jackyzha0/DroneNet/WRITEUP_ARXIV_FORM.pdf

## DRONENET: USING DRONE SWARMS FOR AUTONOMOUS

## SEARCH AND RESCUE

AN INDEPENDENT PROJECT

Jacky Zhao St. George’s School Vancouver, CA
j.zhao2k19@gmail.com

March 1, 2019

ABSTRACT

Current search and rescue methods are very reliant on global communication
methods like GPS or a central control unit. | This limits the range and
efficiency of search and rescue operations. | A decentralized drone swarm
would alleviate these problems by having a theoretically infinite range given number of drones. So far, we have designed and assembled the first drone using 3D printed components and ordered parts, built the recognition network by retraining a YOLOv3 model on the KITTI dataset. The next component would be to implement the decentralized autopilot using a Deep Q-learning Agent or another reinforcement learning algorithm to output velocity deltas.

### 1 Introduction

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

### 2 Proposal

We propose a novel end-to-end algorithm for controlling drone swarms for autonomous search and rescue. This algorithms would be able to,

1. Efficiently navigate a 3D search space,
2. Effectively communicate between an undetermined amount of drones and transfer data (location, images),
3. Detect and identify humans

As this task is extremely difficult, we plan to tackle this task in multiple stages. In the first stage, we plan to create a singular functioning drone which is able to navigate a 2D air space above a clear area, and efficiently find a human.

AN INDEPENDENT PROJECT - MARCH 1, 2019

### 2.1 Hardware

### 2.1.1 Frame

The physical frame of the drone is a modified build of the Firefly 1504 Drone. The mainframe is modified by first expanding the width to be able to fit the battery. Bumper_v2_f.stl and 2x side.stld is printed with 50% infill. Lower_plate_V2.stl, Top_plate_front_3mm.stl, and Top_plate_rear_3mm.stl are printed with 25% infill. Arms are 100mm segments of Carbon Fiber tube with a radius of 6mm. Holes and screws were drilled and assembled as according to the documentation of the Firefly.

### 2.1.2 Cost and Equipment Breakdown

The breakdown of the price and weight data for the construction of the first drone is listed below.

Quantity | Item | Total Weight (g) | Price
1x | 3D Printed Frame | 50.0g | N/A
1x | 1300mAh 4S 45C LiPo Battery | 165.0g | $19.10
4x | 20A 2-4S ESC | 28.0g | $50.68
1x | HobbyKing Lite Power Distribution Board | 19.3g | $4.13
4x | 100mm x 6mm Carbon Fiber Tubes | 45.2g | $7.99
1x | PXFMini Power Module | 50.0g | $44.94
1x | PXFMini | 15.0g | $103.36
4x | EMAX RS2205 Brushless Motor | 120.0g | $39.96
4x | GEMFAN 5045 GRP 3-BLADE Propellers | 21.2g | $8.76
1x | Pi Zero W | 9.0g | $5.00
1x | Pi Camera v1 5MP | 18.1g | $14.99
N/A | Misc. wires, bolts, and nuts | 20.0g | N/A
Totals | N/A | 560.8g | $298.91
Table 1: Price and Weight Breakdown

### 2.1.3 Flight

In calculating the thrust required, we consider that the drone will not be used for racing. As a result, a thrust to weight ratio of 4:1 works well. Using the weight of the drone calculated in 2.1.2, we get a thrust requirement of 2.43kg. Dividing this by the 4 motors, we require 560g of thrust per motor. we decided on using the GEMFAN 5045 propellers (5" diameter, 4.5" pitch). This allows the drone to achieve a thrust of roughly 560g per motor at only 13A draw or 52A total.

Current (A) | Thrust (g) | Efficiency (g/W) | Speed (RPM)
1 | 76 | 4.75 | 7220
3 | 183 | 3.81 | 10790
5 | 282 | 3.54 | 13030
7 | 352 | 3.10 | 14720
9 | 426 | 2.93 | 16180
11 | 497 | 2.82 | 17150
13 | 560 | 2.69 | 18460
15 | 628 | 2.62 | 19270
27 | 997 | 2.28 | 23920
30 | 1024 | 2.14 | 24560
Table 2: Thrust Table for RS2205-2300KV @ 16.8V with GF5045BN

As such, we needed to choose a battery that would allow reasonable flight time given our 52A draw. We can use the Maximum Recommended Current Draw function which is as follows
Imax = CapacityAh · CRating | (1)

For this project, a 1300mAh 4S 45C LiPo Battery was used.

Imax = 1.3Ah · 4C = 58.5A

This max current is greater than the maximum theoretical usage, thus, this battery is safe to use. Using this information, we can calculate the theoretical maximum flight time. To keep the drone in the air, we require approximately thrust equal to the weight of the drone (560g). This translates to roughly 140g of thrust per motor. we assume that the capacity is only 80% effective, meaning 1.04Ah is available. We can then convert to minutes by multiplying by h/60min and dividing by the current draw of 3A. This attains a total flight time of 20.8 minutes.

### 2.1.4 Positioning

A PXFMinwe is used as the data sensor hub and auto-pilot shield. This shield runs on top of the Raspberry Pwe Zero W and allows the drone to be controlled using the APM flight stack. The PXFMinwe is able to get data such as height, global position, velocity, and acceleration. The APM outputs through the PWM Outputs on the back of the PXFMini.

### 2.1.5 Communications

Two main options are available for communication, WiFi and Radio. WiFi communication is achieved by connecting the Raspberry Pi Zero W to a local Wireless Access Point (WAP) hosted on my laptop. Two network interfaces are used. The Asus AC56R Wifi Adapter (rtl8812au driver) is used for WiFi Access while the Builtin Intel Wifi Adapter is used for creating wireless access point. The RPi attempts to start the ArduCopter APM at port 6000 with a UDP link. However, at this point in time, the APM Planner 2 program on my laptop refuses to connect to the port. For now, we will be resorting to traditional RC methods. Currently, we am using a RC controller with a PPMSUM-enabled receiver attached to the PXFMini.

### 2.2 Software

### 2.2.1 Detection Network

The detection network is tasked with identifying and labelling humans within images taken by the Raspberry Pwe Camera. The Tiny YOLOv1 Architecture was chosen for this task as it is has a very quick runtime (∼30ms) on a 970M. Other options such as Full YOLOv1 and SqueezeNet were either too large or took too long to run a image. The architecture was implemented using Tensorflow v1.2.1 modified to run with a [448, 448, 3] dimensional input. Training was done on a combination of the KITTwe and COCO datasets. Performance will be detailed at a later date.

Figure 1: Tiny YOLOv1 Architecture

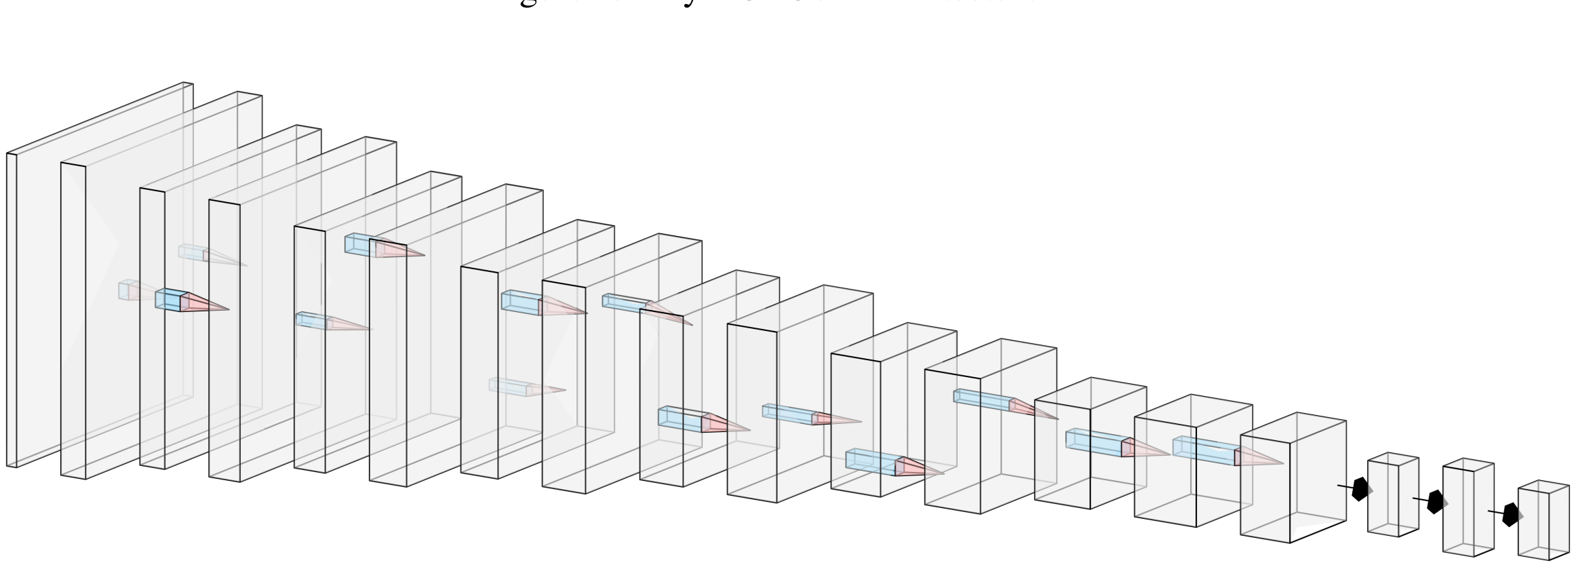
[picture p20: figure]

The dimensions of each layer are determined by that of the layer before Nn, the kernel size K and the stride length S.

Nn =

Nn−1 − K
S
+ 1 | (2)

As such, the dimensions for each layer along with filter sizes are listed below. Layer images is the input layer. All layers beginning with conv are convolutional, layers beginning with maxpool are max pooling layers, and layers beginning with fc are fully connected layers. Interestingly, Tiny YOLOv1 has a unique structure for its output layer. Instead of a rank one tensor for binary classification, YOLOv1 encodes its output in form [batchsize, sx, sy, B * (C + 4)], where B is number of bounding boxes per grid cell and C is number of classes.

Layer | Output Dimensions | Filter Size | Stride | Depth
images | [448, 448, 3] | - | - | -
conv1 | [448, 448, 16] | [3, 3] | [1, 1] | 16
maxpool1 | [224, 224, 16] | [2, 2] | [2, 2] | -
conv2 | [224, 224, 32] | [3, 3] | [1, 1] | 32
maxpool2 | [112, 112, 32] | [2, 2] | [2, 2] | -
conv3 | [112, 112, 64] | [3, 3] | [1, 1] | 64
maxpool3 | [56, 56, 64] | [2, 2] | [2, 2] | -
conv4 | [56, 56, 128] | [3, 3] | [1, 1] | 128
maxpool4 | [28, 28, 256] | [2, 2] | [2, 2] | -
conv5 | [28, 28, 256] | [3, 3] | [1, 1] | 256
maxpool5 | [14, 14, 256] | [2, 2] | [2, 2] | -
conv6 | [14, 14, 512] | [3, 3] | [1, 1] | 512
maxpool6 | [7, 7, 512] | [2, 2] | [2, 2] | -
conv7 | [7, 7, 1024] | [3, 3] | [1, 1] | 1024
conv8 | [7, 7, 256] | [3, 3] | [1, 1] | 256
conv9 | [7, 7, 512] | [3, 3] | [1, 1] | 512
fc1 | [1024] | - | - | -1 (flatten)
fc2 | [4096] | - | - | -
fc3 | [675] | - | - | -
Table 3: DetectionNet Architecture

As seen above, the Tiny YOLOv1 architecture is a simple convolutional network. As a result, we can optimize it with a typical gradient descent optimizer or one of its variants. We opted for an AdamOptimizer with α = 1e−3 and = 1.0, where α represents the learning rate and is a constant that is inversely proportional to the size of the weight updates. This function is called to optimized the below cost function.

loss = λobj (lossdims + lossobjconf + lossprob) + λnoobj (lossnoobjconf ) | (3)

We define two constants that help to correct the unbalance between obj and no_obj boxes, λobj and λnoobj . We set these to 5.0 and 0.5 respectively. Additionally, we define φ as a function that asks like a boolean mask, returning 0 if the object is in that cell and has that bounding box responsible for its prediction and 1 otherwise.

φ

obj
i,j,h =
0 if object is in cell i,j and bounding box h is responsible
1 otherwise | (4)

We define a few variables for the formulas below. sx and sy are defined as number of horizontal grid cells and vertical grid cells respectively. classes is the list of total possible classes. B is the number of bounding boxes per grid cell. δ is defined as a small constant to prevent extremely small numbers. Then, we define the individual terms in the loss function. lossdims is the sum of the squared errors of the x,y,w,h values of bounding boxes for all squares and bounding boxes responsible.

lossdims =

## Xsx

i=0

## Xsy

j=0

X

B

h=0

φ

obj
i,j,h[(xi,j −xˆi,j )

2+(yi,j −yˆi,j )

2+(p
wi,j + δ−

p
wˆi,j + δ)

2+(p
hi,j + δ−

q
hˆ
i,j + δ)

2
]

(5)

lossobjconf is the sum of the squared errors in predicted confidences of all bounding boxes with objects

lossobjconf =

## Xsx

i=0

## Xsy

j=0

X

B

h=0

φ

obj
i,j,h(confi,j − ˆ confi,j )
2
(6)

lossnoobjconf is the sum of the squared errors in predicted confidences of all grid cells with no objects

lossnoobjconf =

## Xsx

i=0

## Xsy

j=0

X

B

h=0

φ

noobj
i,j,h (confi,j − ˆ confi,j )
2
(7)

lossprob is the sum of the squared errors in predicted class probabilities across all grid cells

lossprob =

## Xsx

i=0

## Xsy

j=0

X

c∈classes

φ

obj

i,j,h(p(c)i,j − ˆp(c)
i,j )

2
(8)

We also batch normalize every convolutional layer and fully connected layer before activations. This reduces the internal covariate shift, decreasing the time for convergence. In addition, we use a leaky rectified linear unit (ReLU) with an α = 0.1. We then define some other parameters for training the network.

- sx, sy = [7, 7]
- Batchsize = 16
- B = 3
- C = 4
- Batch Normalization Momentum = 0.9
- Batch Normalization = 1e-5

### 2.2.2 Data Cleanup

Interestingly, KITTI has images that are extremely wide, ranging from [1224, 370] to [1242, 375]. As a result, we need to do additional preprocessing before they are usable.

Images

- Resizing all images to uniform size of [1242, 375] with cubic interpolation
- Crop randomly to [375, 375]
- Normalize RGB to range [0., 1.]
- Pad image size to [448, 448]

Resizing then cropping allows us to attain a size closer to 1:1 which is recommended with CNNs with square kernels. We then normalize the color data to ensure that the scale of input remains constant.

Labels In the dataset, labels are kept within annotation files. Data is stored in 15 separate columns listed as follows.

1. Class - Car, Van, Truck, Pedestrian, Person Sitting, Cyclist,
2. Tram, Misc., Don’t Care
3. Boolean, if the bounding box is truncated (leaves the screen)
4. Boolean, if the bounding box/class is partially obscured
5. Observation angle - Range from -π to π
6. Bounding box xmin coordinate
7. Bounding box ymin coordinate
8. Bounding box xmax coordinate
9. Bounding box ymax coordinate
10. 3D - x dimension of object
11. 3D - y dimension of object
12. 3D - z dimension of object

13. x location
14. y location
15. z location
16. ry rotation around y-axis

As we are only concerned with classes and bounding boxes, only columns 1,5,6,7,8 will be used. We then process the labels as follows.

- Discard all labels that are not Car / Pedestrian / Cyclist / Misc. Vehicle (Truck or Van)
- Discard all labels outside crop range
- One-hot encode labels
- Convert p1, p2 to x, y, w, h
- Assign boxes to cells
- Normalize w, h to cell dimensions
- Normalize x, y to image dimensions
- Append obj, noobj, objI boolean masks

First, we discard all labels that we are not interested in. Then, as we crop the image, we discard all labels outside that crop range. Then, the labels are one hot encoded to normalize cost. We convert coordinates from form p1, p2 (which encodes the x, y coordinates of the top left and bottom right corners of each bounding box) to form x, y, w, h (which encodes the x, y coordinates of the center of the box as well as the height and the width). Each label is then assigned a grid cell, effectively normalizing x, y, w, h to the dimensions of each cell. Boolean masks are then generated depending on whether the grid cell has an object of not.

### 2.2.3 Navigation Network

This part is still very much under construction. This algorithm would be responsible for controlling the actual path of the drones. We plan to create a decentralized autopilot with a Deep Q-Neural Network which is a form of reinforcement learning. We propose the input to be of form [n, r, φ, θ] where n is number of total drones, r is distance away in pixels, phi is azimuth angle, and theta is elevation angle. We assume r to be infinity when out of range. The goal of the algorithm is to cover the area in the smallest time possible while maintaining communication distance. As a result, the cost function should be affected by total flight time and integral of the distance between drones. Currently, we plan on using a long-short term memory cell (LSTM) networks with the outputs being the velocity deltas in the shape of [n, dx, dy, dz], however, other architectures are being evaluted as well.
