jackyzha0/DroneNet/calPiCamera/0.jpg

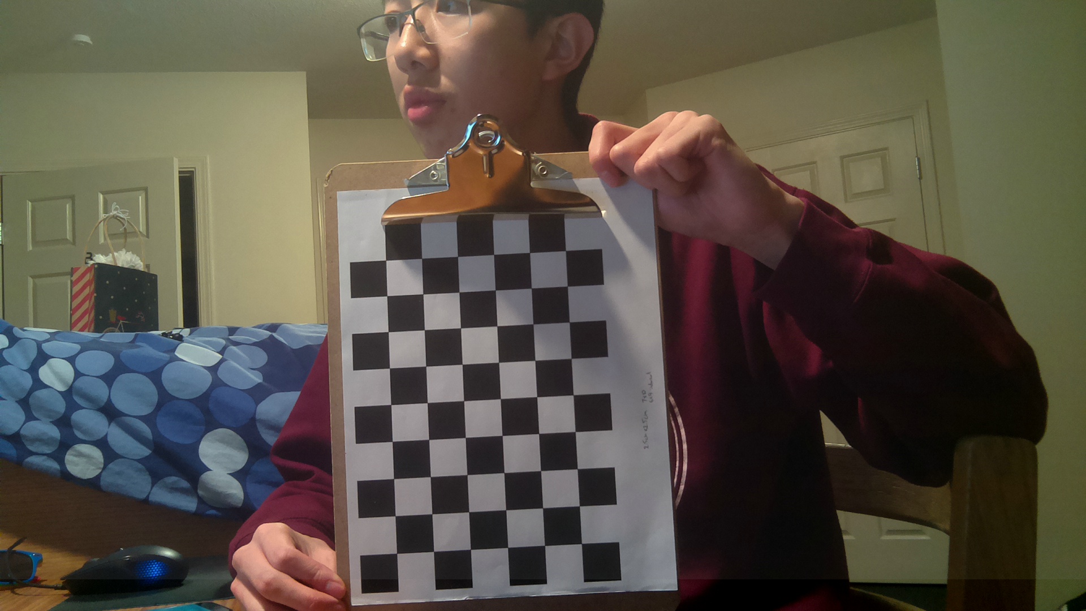
calPiCamera/0.jpg
