jackyzha0/DroneNet/calPiCamera/1.jpg

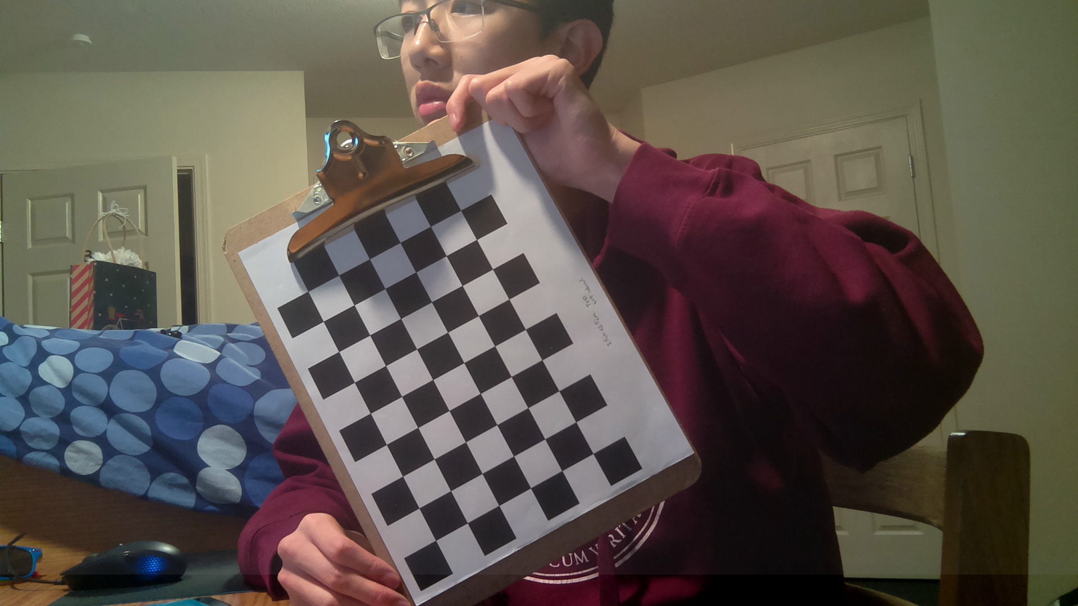
calPiCamera/1.jpg
