jackyzha0/DroneNet/calPiCamera/2.jpg

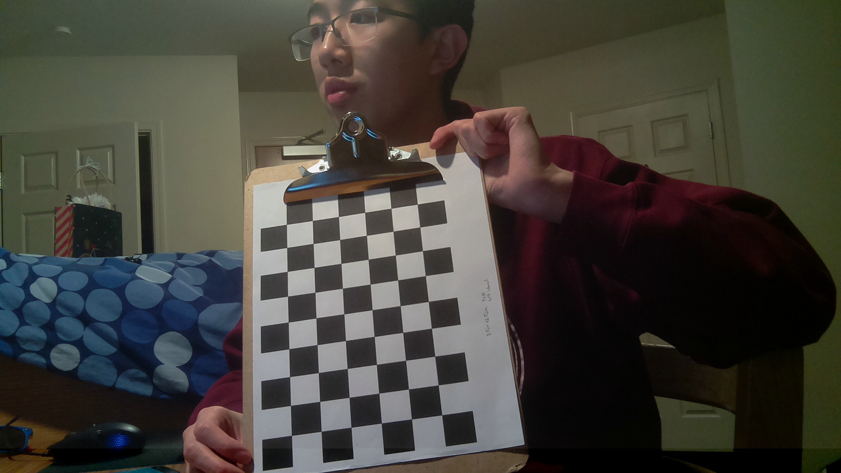
calPiCamera/2.jpg
