jackyzha0/DroneNet/calPiCamera/3.jpg

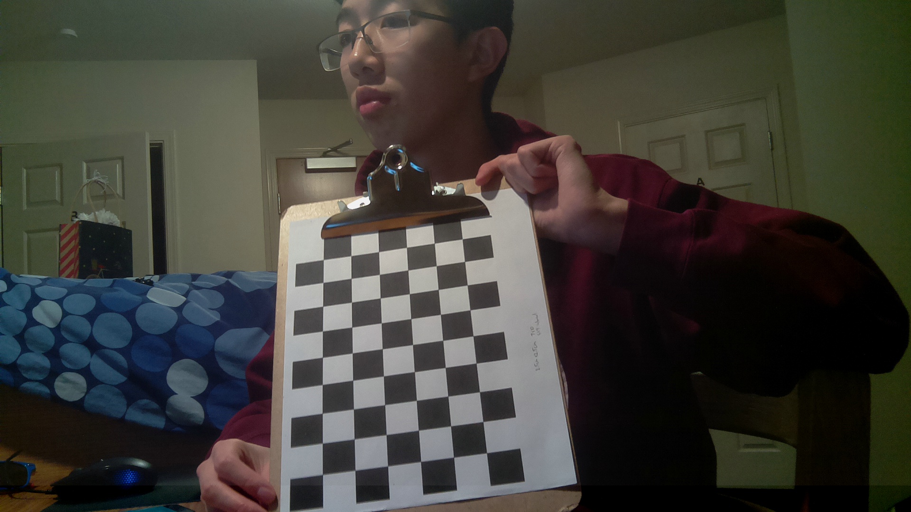
calPiCamera/3.jpg
