jackyzha0/DroneNet/calPiCamera/4.jpg

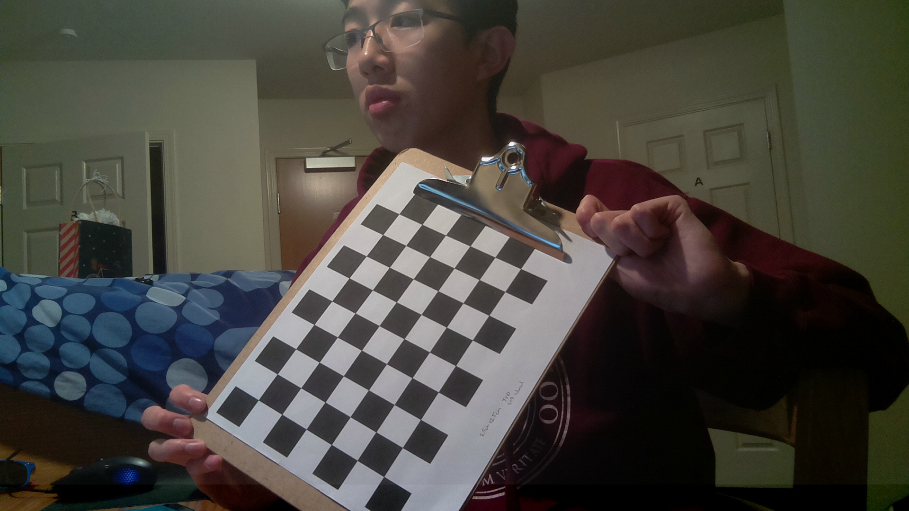
calPiCamera/4.jpg
