jackyzha0/DroneNet/calPiCamera/5.jpg

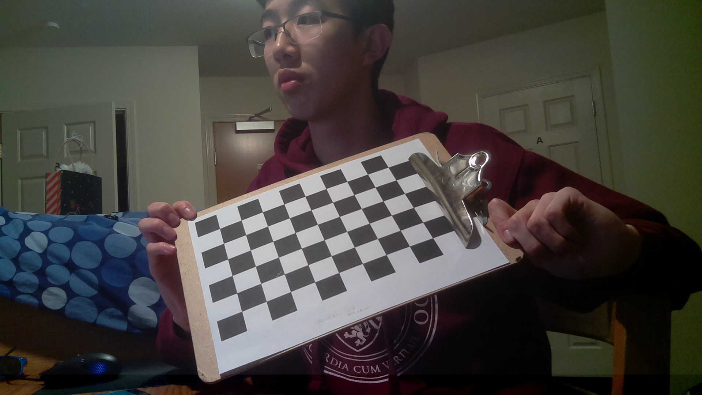
calPiCamera/5.jpg
