jackyzha0/DroneNet/calPiCamera/6.jpg

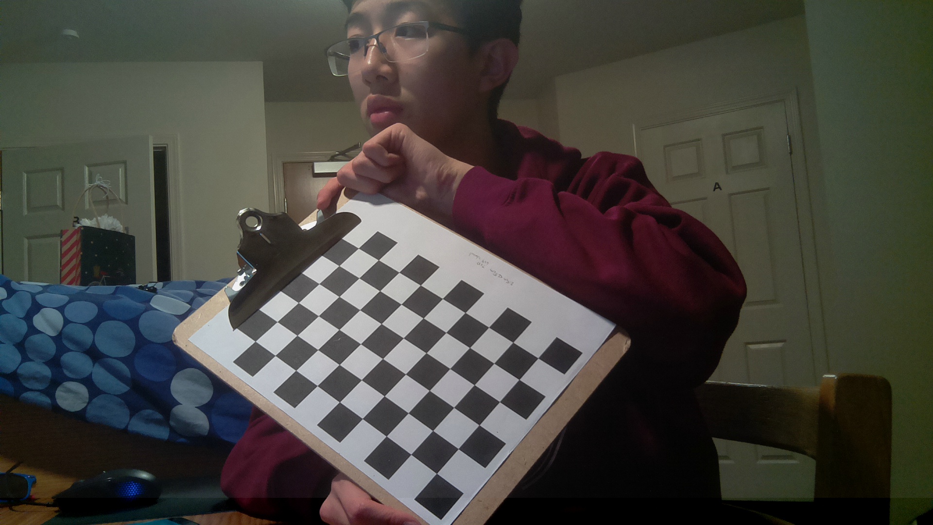
calPiCamera/6.jpg
