jackyzha0/DroneNet/calPiCamera/7.jpg

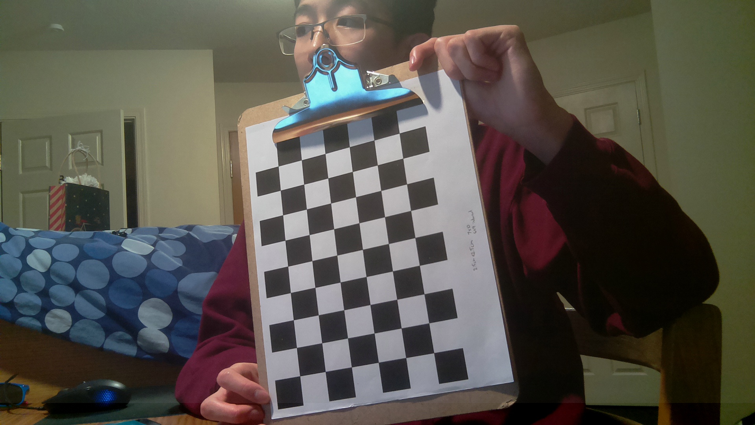
calPiCamera/7.jpg
