jackyzha0/DroneNet/calPiCamera/8.jpg

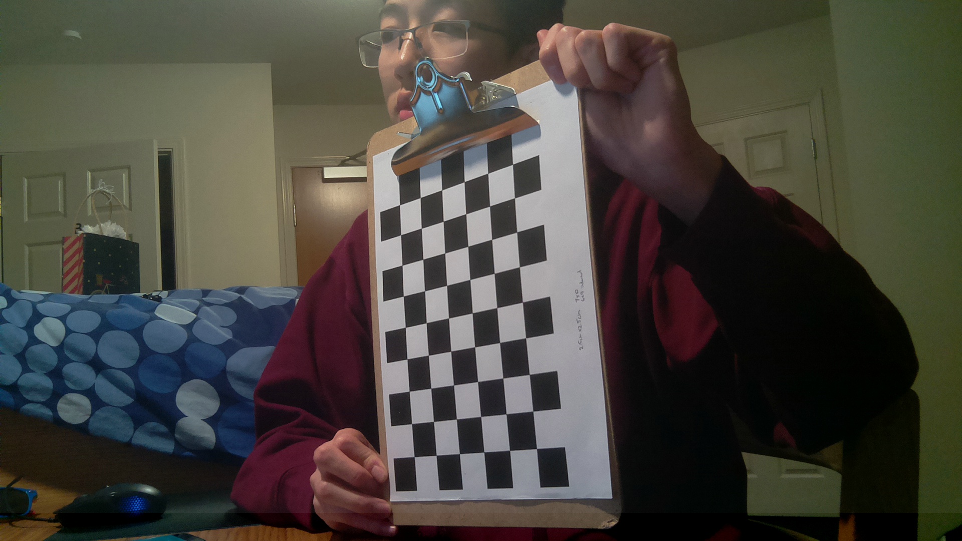
calPiCamera/8.jpg
