jackyzha0/DroneNet/calPiCamera/9.jpg

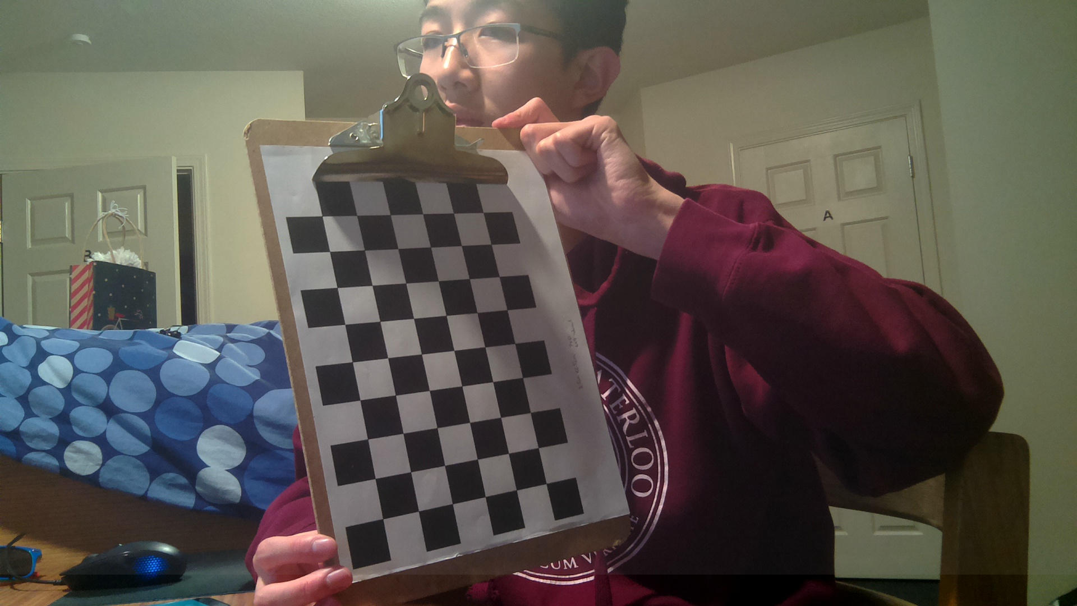
calPiCamera/9.jpg
