jackyzha0/DroneNet/calPiCamera/10.jpg

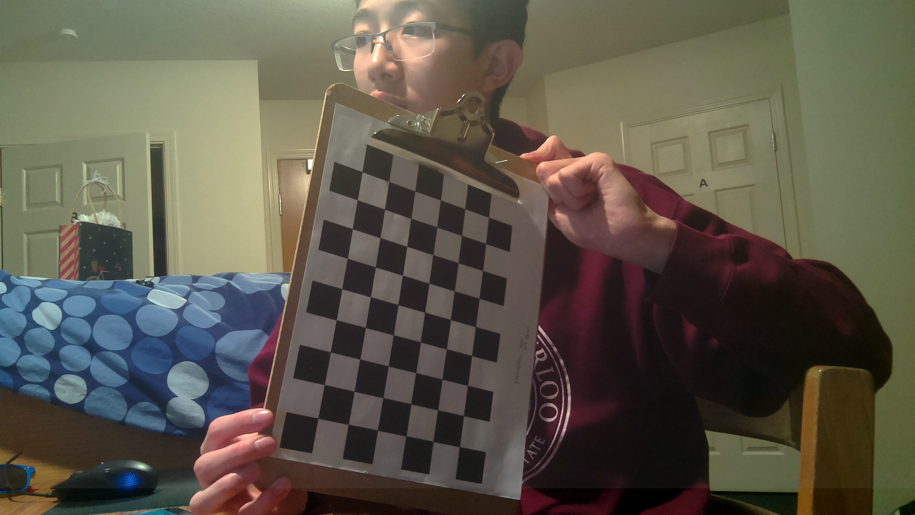
calPiCamera/10.jpg
