jackyzha0/DroneNet/calPiCamera/11.jpg

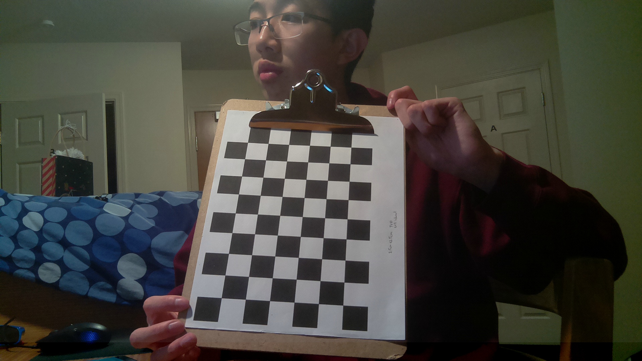
calPiCamera/11.jpg
