jackyzha0/DroneNet/Logs/e28aad952cd21ddd2f674ffbbf860939.png

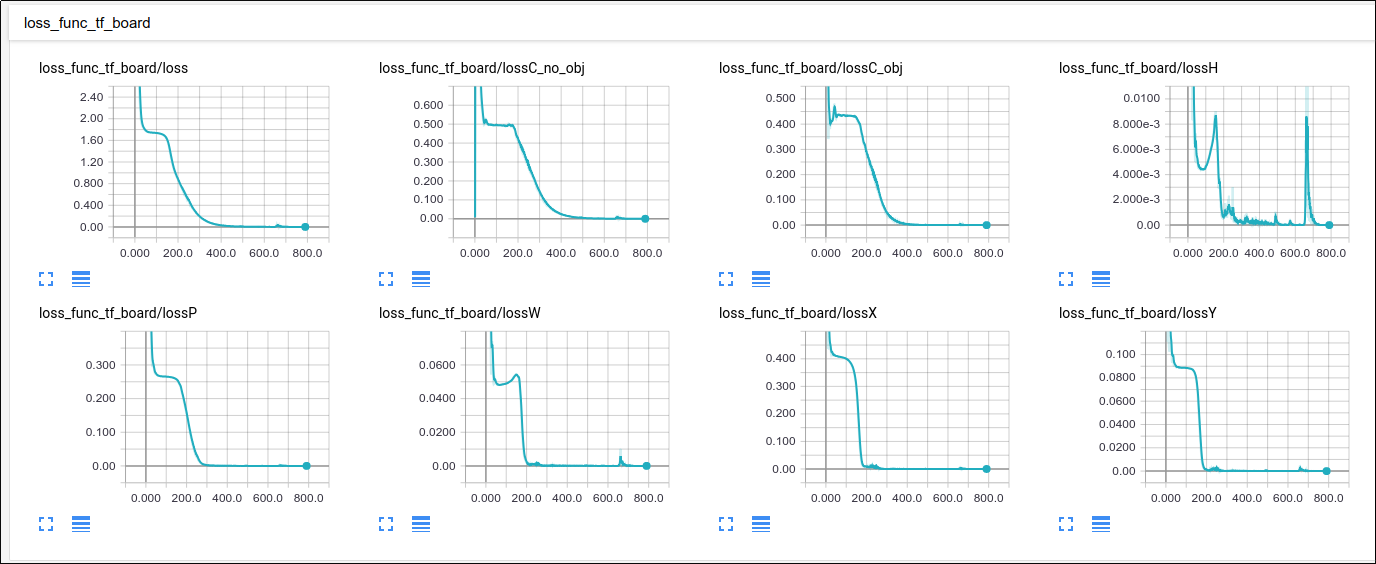
Logs/e28aad952cd21ddd2f674ffbbf860939.png
