jackyzha0/DroneNet/Logs/e227e22399f4c8b6e7aaa148d091114a.png

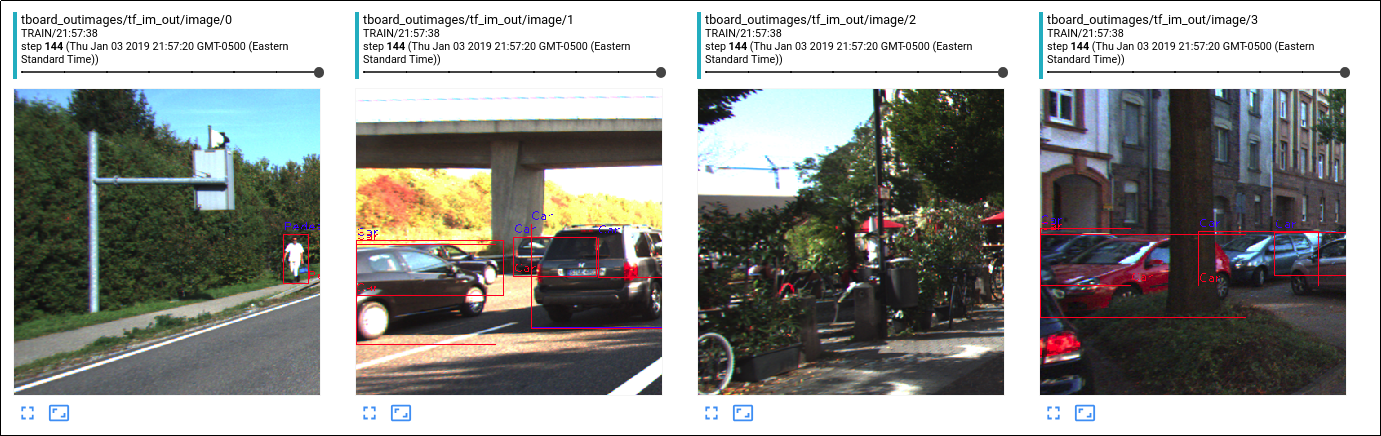
Logs/e227e22399f4c8b6e7aaa148d091114a.png
