jackyzha0/DroneNet/Firefly Drone Parts/MainFrame/README.txt

Print Bumper_v2_f.stl and side.stld with 50% infill
Print Lower_plate_V2.stl, Top_plate_front_3mm.stl, and Top_plate_rear_3mm.stl with 25% infill
