jackyzha0/DroneNet/Firefly Drone Parts/Arms/motor_stand_v2.stl

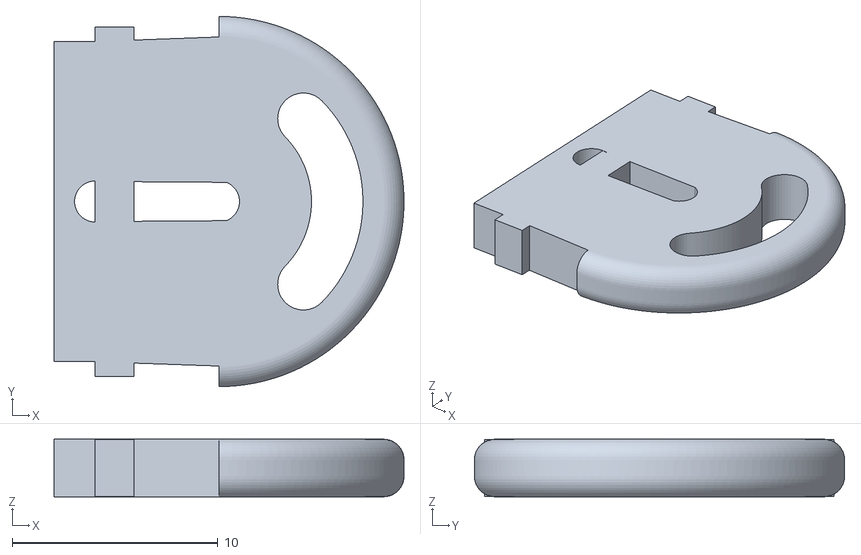
[picture p35: CAD file, 2018-10-30]
Firefly Drone Parts/Arms/motor_stand_v2.stl
17.0 x 18.0 x 2.80
