jackyzha0/DroneNet/Firefly Drone Parts/Drill Jig/Carbon_drill_jig.stl

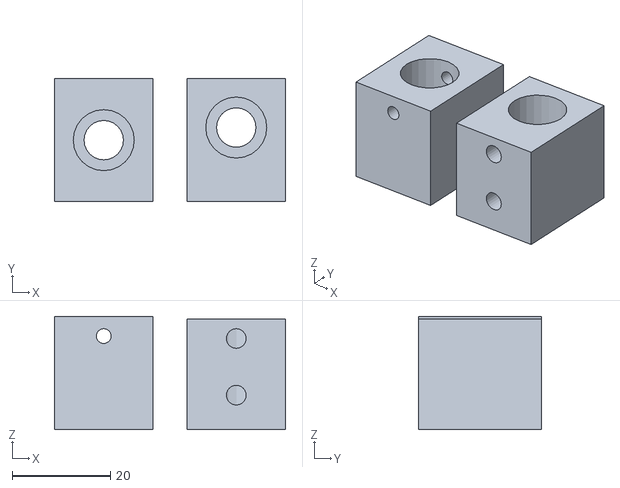
[picture p36: CAD file, 2018-10-11]
Firefly Drone Parts/Drill Jig/Carbon_drill_jig.stl
46.9 x 25.1 x 23.0
