jackyzha0/DroneNet/Firefly Drone Parts/MainFrame/CameraMountTop.stl

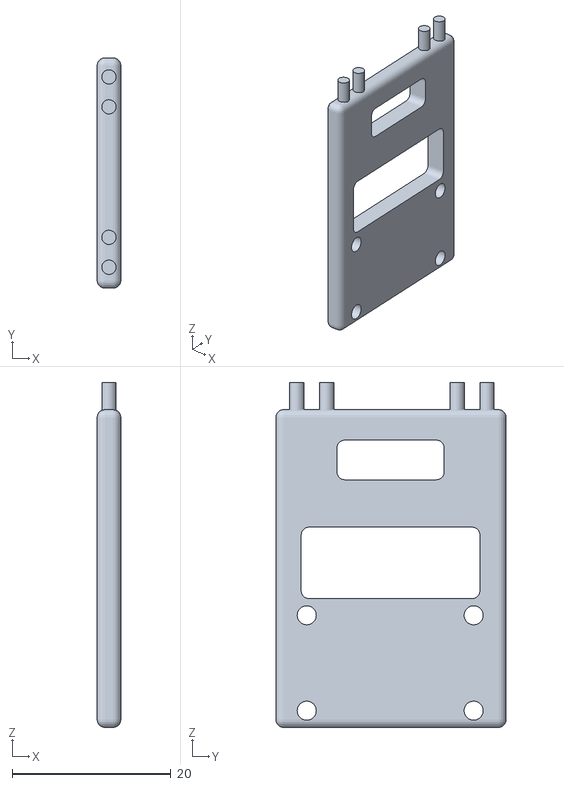
[picture p37: CAD file, 2018-11-12]
Firefly Drone Parts/MainFrame/CameraMountTop.stl
3.00 x 29.0 x 43.4
