jackyzha0/DroneNet/Firefly Drone Parts/Drill Jig/carbon_cutting_jig.stl

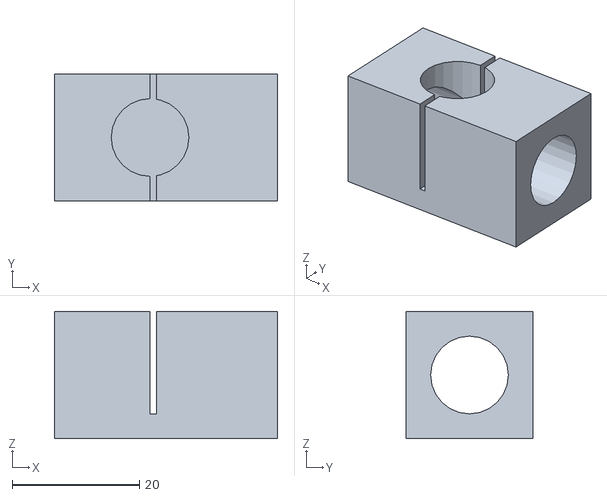
[picture p38: CAD file, 2018-10-11]
Firefly Drone Parts/Drill Jig/carbon_cutting_jig.stl
35.0 x 20.0 x 20.0
