jackyzha0/DroneNet/Firefly Drone Parts/MainFrame/CameraMountBottom.stl

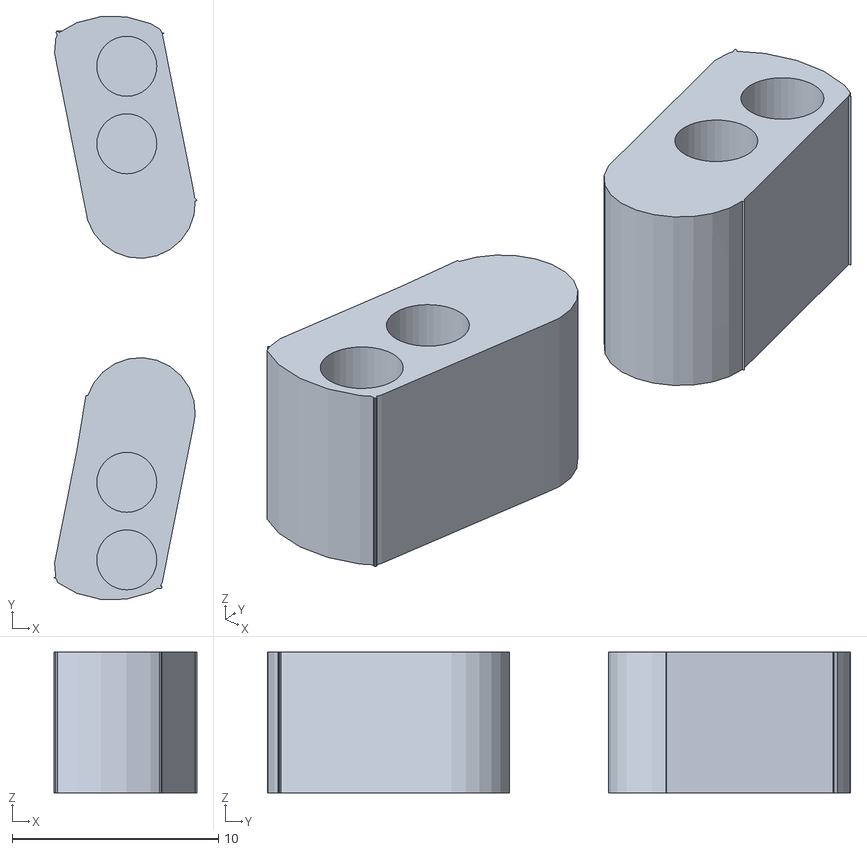
[picture p39: CAD file, 2018-11-07]
Firefly Drone Parts/MainFrame/CameraMountBottom.stl
6.93 x 28.3 x 6.82
