jackyzha0/DroneNet/Firefly Drone Parts/Arms/cliplock_rev3.3.stl

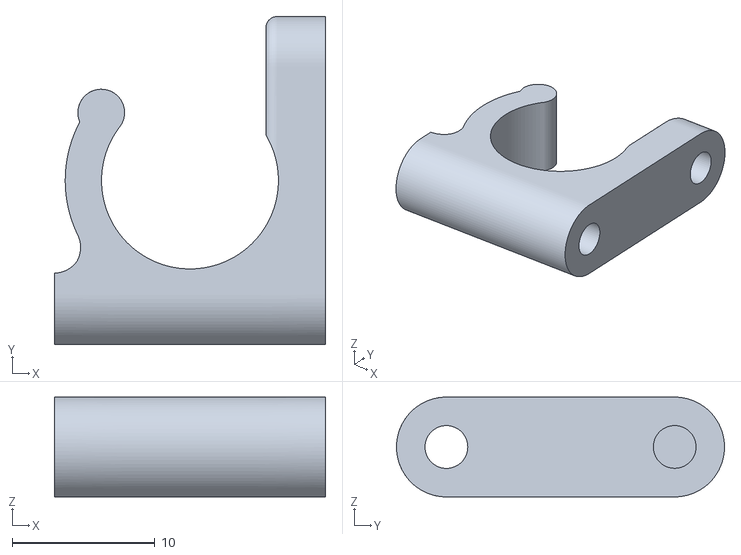
[picture p40: CAD file, 2018-10-11]
Firefly Drone Parts/Arms/cliplock_rev3.3.stl
19.0 x 23.0 x 7.00
