jackyzha0/DroneNet/Firefly Drone Parts/MainFrame/pdb_mount.stl

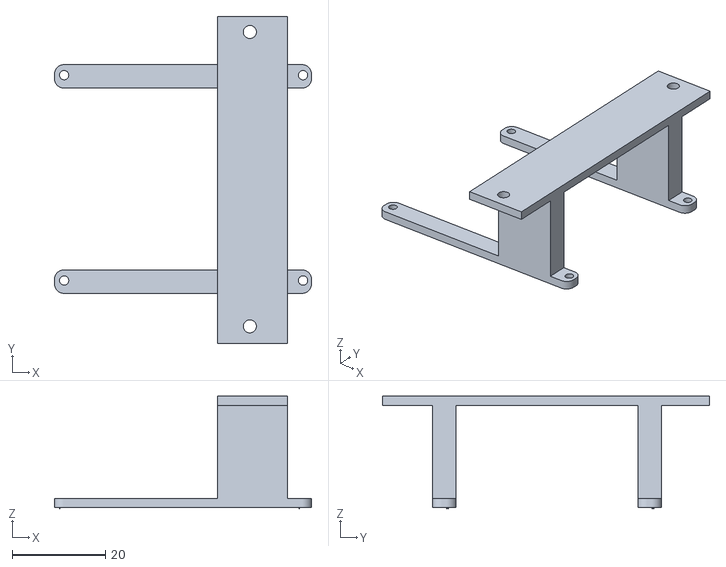
[picture p41: CAD file, 2018-11-01]
Firefly Drone Parts/MainFrame/pdb_mount.stl
55.0 x 70.0 x 24.1
