jackyzha0/DroneNet/Firefly Drone Parts/Arms/motormount_rev2.stl

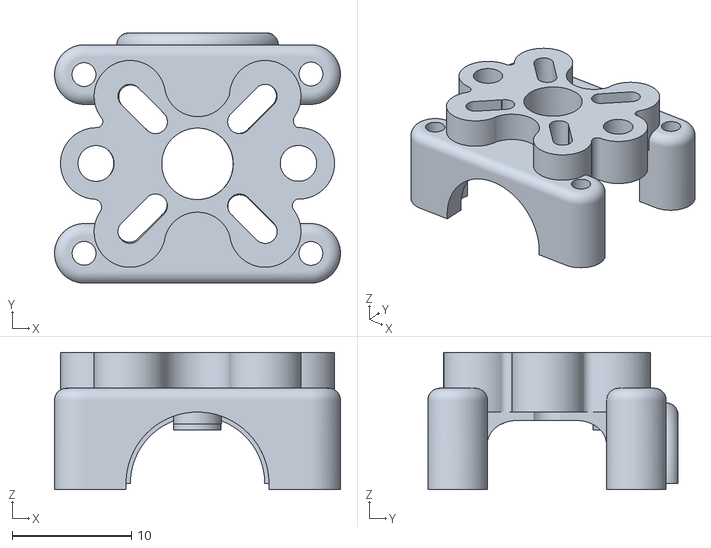
[picture p42: CAD file, 2018-10-11]
Firefly Drone Parts/Arms/motormount_rev2.stl
24.0 x 21.0 x 11.5
