jackyzha0/DroneNet/Firefly Drone Parts/MainFrame/Bumper_v2_f.stl

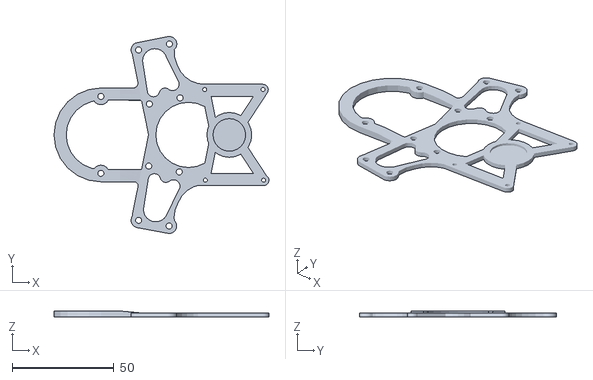
[picture p43: CAD file, 2018-10-11]
Firefly Drone Parts/MainFrame/Bumper_v2_f.stl
105.4 x 96.6 x 3.00
