jackyzha0/DroneNet/Firefly Drone Parts/Arms/motor_mount_bottom.stl

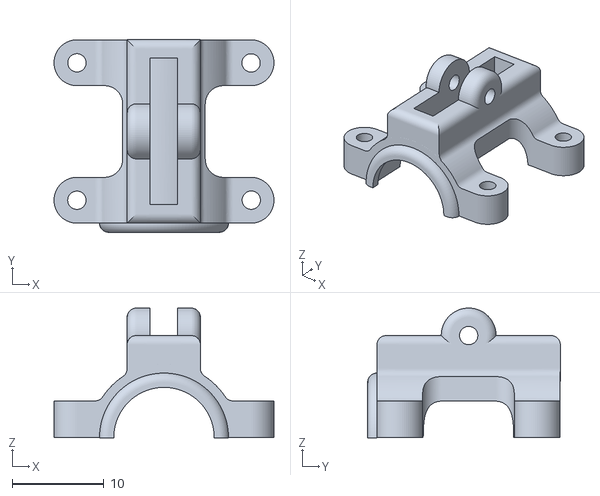
[picture p44: CAD file, 2018-10-11]
Firefly Drone Parts/Arms/motor_mount_bottom.stl
24.0 x 21.0 x 14.2
