jackyzha0/DroneNet/Firefly Drone Parts/MainFrame/Top_plate_rear_3mm.stl

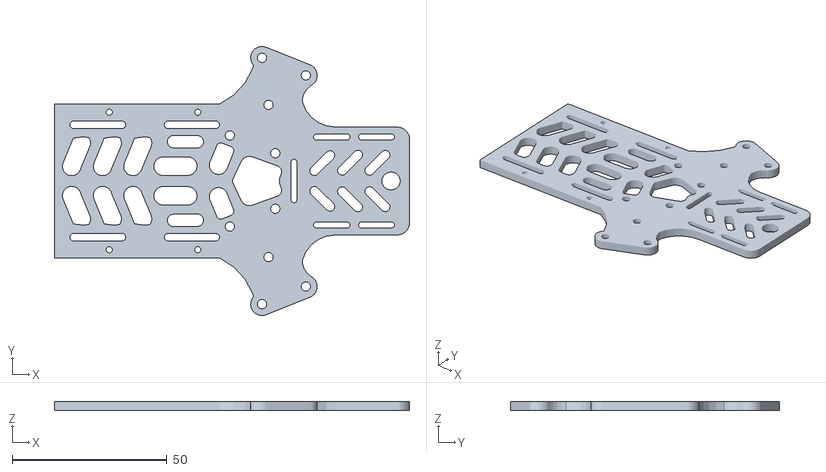
[picture p45: CAD file, 2018-10-11]
Firefly Drone Parts/MainFrame/Top_plate_rear_3mm.stl
114.7 x 86.9 x 3.00
