jackyzha0/DroneNet/Firefly Drone Parts/Arms/motormount_plate_2mm.stl

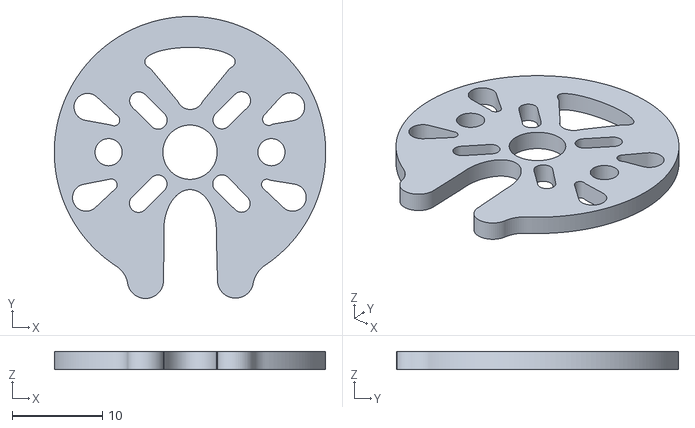
[picture p46: CAD file, 2018-10-11]
Firefly Drone Parts/Arms/motormount_plate_2mm.stl
30.0 x 31.2 x 2.00
