jackyzha0/DroneNet/Firefly Drone Parts/MainFrame/Top_plate_front_3mm.stl

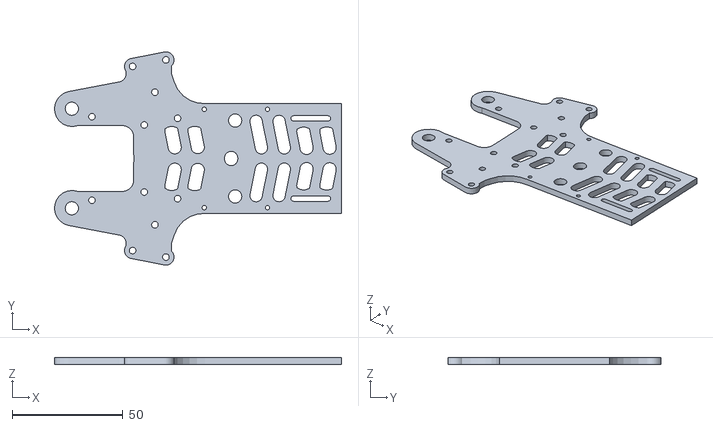
[picture p47: CAD file, 2018-10-11]
Firefly Drone Parts/MainFrame/Top_plate_front_3mm.stl
129.8 x 96.5 x 3.00
