jackyzha0/DroneNet/Firefly Drone Parts/Arms/Arm_hinge_v3.stl

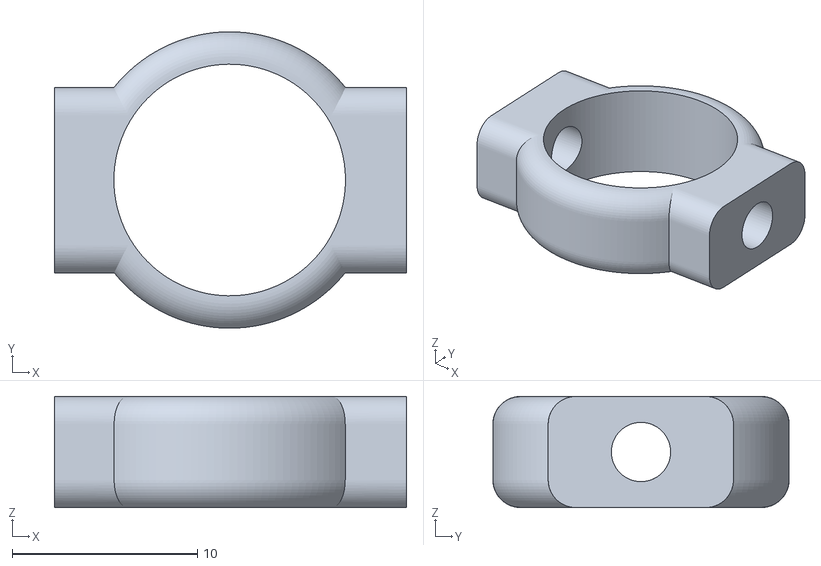
[picture p48: CAD file, 2018-10-11]
Firefly Drone Parts/Arms/Arm_hinge_v3.stl
19.0 x 16.0 x 6.00
