jackyzha0/DroneNet/Firefly Drone Parts/MainFrame/Lower_plate_V2.stl

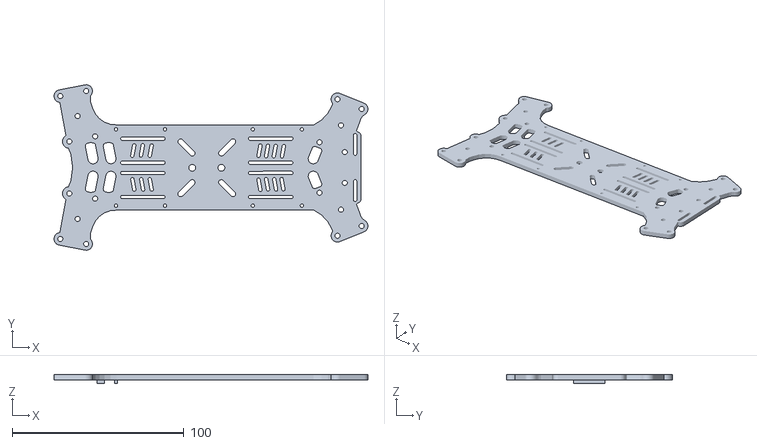
[picture p49: CAD file, 2018-10-11]
Firefly Drone Parts/MainFrame/Lower_plate_V2.stl
183.1 x 96.5 x 5.00
