jackyzha0/DroneNet/Firefly Drone Parts/Arms/motor_mount_part_2.stl

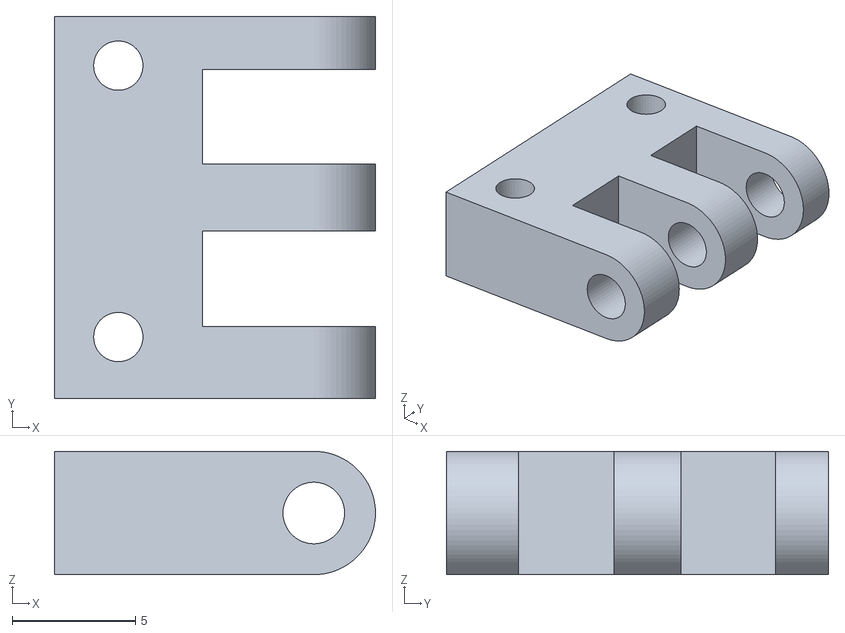
[picture p50: CAD file, 2018-10-11]
Firefly Drone Parts/Arms/motor_mount_part_2.stl
13.0 x 15.5 x 5.00
