jackyzha0/DroneNet/Firefly Drone Parts/MainFrame/side.stl

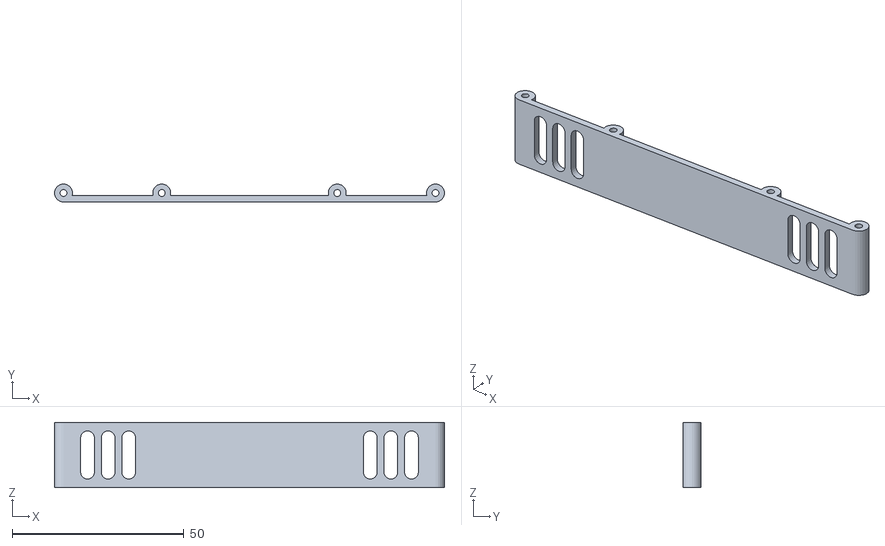
[picture p51: CAD file, 2018-10-11]
Firefly Drone Parts/MainFrame/side.stl
113.6 x 5.25 x 19.0
