jackyzha0/DroneNet/Firefly Drone Parts/Arms/motor_stand.stl

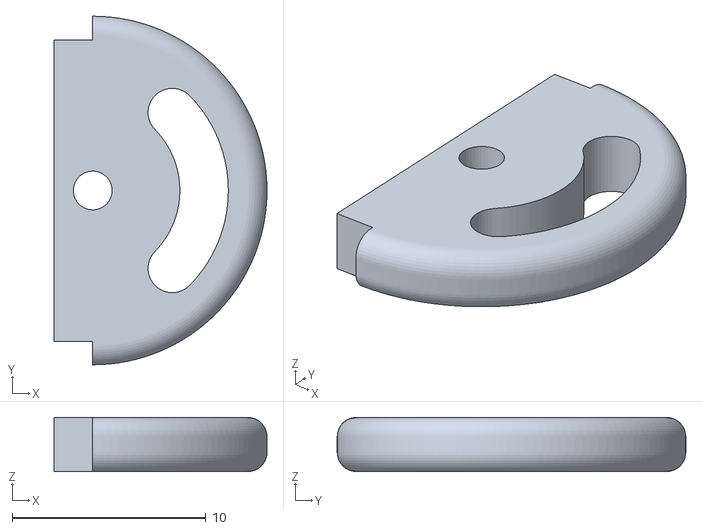
[picture p52: CAD file, 2018-10-11, an earlier design]
Firefly Drone Parts/Arms/motor_stand.stl
11.0 x 18.0 x 2.80
