jackyzha0/DroneNet/(threads)

Thread 1 (2019-01-09):

Validation error increases as training goes on

jackyzha0, 2019-01-09:
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

jackyzha0, 2019-01-10:
WIP: Switching to COCO dataset

jackyzha0, 2019-01-12:
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

Closed 2019-01-12.
