jackyzha0/DroneNet/(commit log)

2018-10-10 Added KLT Feature Tracking, working on camera calibration
2018-10-11 README Update and STL files
    [Arm_hinge_v3.stl, Bumper_v2_f.stl, Camera_mount_part_1.stl, Carbon_drill_jig.stl, Lower_plate_V2.stl, Top_plate_front_3mm.stl, Top_plate_rear_3mm.stl, camera_plate.stl]
2018-10-15 Parts update
    [Arm_hinge_v3.stl, Carbon_drill_jig.stl, carbon_cutting_jig.stl, cliplock_rev3.3.stl, motor_mount_bottom.stl, motor_mount_part_2.stl, motor_stand.stl, motormount_plate_2mm.stl]
2018-10-16 3D Printing Update + README.md formatting
2018-10-17 Price Approximation
    [Arm_hinge_v3.stl, Bumper_v2_f.stl, Camera_mount_part_1.stl, Carbon_drill_jig.stl, Lower_plate_V2.stl, Top_plate_front_3mm.stl, Top_plate_rear_3mm.stl, camera_plate.stl]
2018-10-24 Added directionality for camera
2018-10-24 Camera Direction Drawing
2018-10-30 README Update
    [motor_stand_v2.stl]
2018-10-31 Added camera mount and power distributor mount, working on picamera
    [CameraMount.stl, pdb_mount.stl]
2018-10-31 C4D Model Update
    [CameraMount.stl]
2018-10-31 Added calibrate.py
2018-10-31 Fixed calibration and undistortion
    [calibrate.py]
2018-11-01 STL Update
    [CameraMount.stl, pdb_mount.stl]
2018-11-01 Optimized Mesh of Camera Mount
2018-11-01 Documentation and fixes for calibrate.py
    [calibrate.py, drone.py]
2018-11-01 Added Reprojection Error calculation to calibrate()
    [calibrate.py]
2018-11-05 Reoptimized Camera Mount
2018-11-12 More cleanup
    [CameraMountTop.stl, Camera_mount_part_1.stl, camera_plate.stl]
2018-11-19 Calibrated intrinsic matrix according and refactored calibrate.py
2018-11-19 Fixed code for intrinsic matrix
    [calibrate.py, drone.py, drone_test.py]
2018-12-24 Improved flow of DetectionNet
2018-12-26 Fixed bounding box drawing for new format
    [dataset.py, detectionNet.py]
2018-12-26 Added feeding, fix by casting all arrays to numpy
    [detectionNet.py]
2018-12-27 Training loss completed, TODO fix NAN loss
    [detectionNet.py]
2018-12-30 Fixed bounding boxes being labeled incorrectly
    [dataset.py, detectionNet.py]
2018-12-30 Fixed mislabeling of objI
    [dataset.py, detectionNet.py]
2019-01-03 Linearized last layer and fixed bounding display
    [dataset.py, detectionNet.py]
2019-01-04 Switch to np pickle format
2019-01-06 Revert to CPU, fixed "train" param
    [detectionNet.py]
2019-01-06 Validation printing
2019-01-07 Ensure weight saving saves current epoch
2019-01-07 Fixed conf filter func
    [stats.py]
2019-01-08 Added function documentation for calibrate.py
2019-01-08 Catch zero div error in stats
    [detectionNet.py, stats.py]
2019-01-08 Fixed checkpoint restore and updated .gitignore
    [calibrate.py, dataset.py, detectionNet.py, stats.py]
2019-01-09 Fixed batch norm during test
    [detectionNet.py]
2019-01-10 Architecture switching
2019-01-12 Fixed batch norm test loss not decreasing
    [detectionNet.py, npWrite.py, train.py]
2019-03-27 Added boot config
    [config.txt]
2019-05-08 Updated README and added GPS fix config
    [Erle-GPS-config.txt]
